SahinS14/ShuddhiSetu/DESIGN_IDEAS.md

This design solves two big problems: **thread fouling** (bentonite dust destroys threads) and **mechanical complexity** (clamps/bolts require extra parts).

Here is how to adapt this cookware concept into a rugged industrial sanitation device.

### 1. Why this works for "Severe Service" (Dust + Pressure)

The oval lid is that the **lid itself is physically larger than the hole** along one axis.

* **Blowout Proof:** In a standard "outside" lid, if the bolts fail, the lid becomes a projectile. In this "inside" design, the pressure pushes the lid *against* the metal rim of the chamber. It is mechanically impossible for the lid to blow off while pressurized.
* **Foul-Resistant:** Because there are no threads, there are no small crevices for your bentonite/magnetite dust to pack into. If dust gets on the rim, the massive force of the internal pressure (the "self-energizing" effect) will simply crush the gasket over the dust, maintaining the seal.

### 2. The Geometry: How to Manufacture It

You do not need complex castings. You can manufacture this using standard stainless steel plate.

* **The Shape:** Both the chamber opening and the lid are **Ellipses** (ovals).
* *Example:* If your opening is 6 inches wide (minor axis) and 7 inches long (major axis), your lid would be 6.5 inches wide and 7.5 inches long.

* **The Insertion Motion:** To insert the lid, you turn it 90 degrees so the lid's *short* side fits through the hole's *long* side. Once inside, you rotate it back 90 degrees and pull it up.
* **Material:** 316 Stainless Steel is ideal for urine/corrosion resistance.

### 3. Adapting for Automation (The "Internal Hinge")

The only downside of the Indian cooker design is that it requires a complex human hand motion (insert, twist, rotate, pull). To make this "mechanically simple" for a device that might be automated or operated easily by a user:

**Add a Single Internal Hinge.**
Instead of a loose lid, attach the oval lid to a hinge *inside* the vessel.

* **Operation:** When the user (or actuator) pushes a lever, the lid swings down and "collapses" slightly into the chamber.
* **Closing:** A spring pulls the lid back up against the hole.
* **Benefit:** This keeps the lid aligned perfectly every time. The user doesn't have to fiddle with the geometric puzzle of fitting the oval through the hole; the hinge guides it.

### 4. The Seal Interface (Combining your ideas)

To make this work with the "high compliance" idea:

1. **The Gasket:** Place a thick, soft **Silicone or EPDM gasket** around the *top rim* of the oval lid.
2. **The Seat:** The rim of the chamber opening should be smooth.
3. **The "Pre-Tension":** You mentioned a "partial seal." In the Indian cooker, a handle clips onto a bar to pull the lid up gently. For your device, use a **Simple Cam Lever**.
* *Step 1:* User drops lid in.
* *Step 2:* User pulls a small lever that pulls the lid up with ~5 lbs of force. This squishes the soft gasket just enough to make it airtight.
* *Step 3:* Induction starts -> Pressure builds -> Lid seals with 1000+ lbs of force.

### 5. Specific Caution: Induction Heating

* **Risk:** If your induction coils are wrapped around the *outside* of the stainless steel chamber near the lid, the **lid itself might heat up** via induction, potentially melting your gasket.
* **Solution:** Ensure your induction coils are focused lower down on the magnetite payload, or use a non-conductive ceramic/composite spacer ring between the heated zone and the steel sealing rim.

### Summary

It is the most robust, fail-safe, and foul-resistant pressure vessel design available.

* **Action:** Design an elliptical opening.
* **Seal:** Top-mounted gasket on the lid.
* **Mechanism:** "Drop, Twist, Pull" (manual) or "Internal Hinge" (semi-auto).

---

## Update: Critical Design Decision - The "Potted" Internal Coil

This is a critical design decision.

For your specific goal—heating the **Magnetite** directly (to use its high surface area for rapid evaporation)—the answer is **INSIDE**.

### The Physics: Why "Outside" Fails

If you wrap induction coils around the *outside* of a stainless steel or aluminum pressure vessel:

1. **Faraday Cage Effect:** The metal wall will intercept the magnetic field.
2. **Wall Heating:** The induction energy will heat the **chamber wall**, not the magnetite. The wall will get extremely hot, and the magnetite will only heat up slowly via conduction from the wall. This defeats the purpose of using magnetite as a volumetric heating element.
3. **Aluminum Efficiency:** If you use Aluminum, it is so conductive that it will reflect/absorb almost 100% of the field instantly.

### The Solution: The "Potted" Internal Coil

You must place the coils **inside** the pressure boundary, but you cannot expose bare copper coils to urine and abrasive clay.

* **Design:** Cast the copper induction coil inside a cylinder of **high-temperature refractory cement** or **castable silicone**.
* **Function:** This creates a "removable liner" (like a bucket). The waste goes inside this liner.
* **Safety:** The Stainless Steel pot handles the **pressure**. The Ceramic Liner handles the **electricity and heat**.

### 2. The Magnetite Catalyst (CO & NOx Killer)

Magnetite acts as a dual-function catalyst here:

1. **Oxidation:** Converts Carbon Monoxide () to Carbon Dioxide ().
2. **De-NOx (SCR):** Your waste contains **Urine** (Ammonia/Urea). In the presence of Magnetite and heat, the Ammonia reacts with Nitrogen Oxides () to form harmless Nitrogen () and Water. This is the exact principle used in diesel trucks (SCR), but you are generating your own "Diesel Exhaust Fluid" (ammonia) from the urine!

**Heating Method:**

* **Do not use a second induction coil.** It adds massive complexity (interference between coils, dual power supplies).
* **Use a Cartridge Heater.** A simple, robust stainless steel heating rod inserted down the center of your catalyst tube. It is cheap, easy to control (PID), and robust.

### 3. Updated Design: The "All-in-One" Lid Assembly

* **The Pot:** Remains a simple Oval shell.
* **The Liner:** Remains the Ceramic/Induction bucket.
* **The Lid:** Now features a **"Reaction Tower"**.
* **Bottom:** Steam Valve.
* **Middle:** Magnetite Catalyst Chamber (heated).
* **Top:** Clean Exhaust Outlet.

### 4. Technical Explanation of the "Tower"

#### A. The Steam Cleaning Valve (Blue Block)

* **Placement:** Directly above the lid center hole.
* **Logic:** The valve is the "Gatekeeper."
* **Phase 1 (Cooking):** Valve Closed. Pressure builds to 15 PSI. Temperature hits 121°C. Sterilization occurs.
* **Phase 2 (Venting):** Valve Opens. The 15 PSI pressure blasts steam through the valve. This high velocity prevents "gunk" from settling on the seat.
* **Component:** Use a **PTFE-seated Stainless Steel Solenoid Valve** (rated for >180°C steam).

#### B. The Magnetite Catalyst (Dark Grey Cylinder)

* **Placement:** Immediately *after* the valve.
* **Why here?** The gas leaving the valve is hot, but maybe not hot enough for catalysis (needs ~300°C+).
* **The Heater (Gold Rod):** A **Cartridge Heater** runs down the center of the pipe.
* It heats the Magnetite pellets surrounding it to ~350°C.
* As the VOCs, CO, and Steam pass through the hot pellets, they are "cracked" and oxidized.
* **Efficiency:** Because the gas is forced through the hot pellet bed, contact time is high. The "Cartridge Heater in the Center" is the most energy-efficient way to heat a gas stream (heating from the inside out).

#### C. Electrical Feedthrough (Goldenrod)

* Since the coil is inside the pot, we need to get power to it.
* The Lid has a **High-Amperage Ceramic Feedthrough**.
* **Connection:** When you lower the lid into the pot, you plug the coil into the bottom of the lid (using a high-temp connector like a ceramic terminal block), then twist and lock the lid.

### 5. High-Temperature Bottom Cartridge (H2S Scrubbing)

To prevent downstream corrosion of the steam valve and heat exchanger, a high-temperature scrubbing cartridge is integrated at the bottom of the vessel.

* **Placement:** Located at the base of the reaction vessel, serving as the exit "choke point" for the downdraft gas flow.
* **Composition:** A modular Silicon Carbide (SiC) and Magnetite matrix.
* **Function:** Operates at peak induction temperatures (800°C+) to chemically strip Hydrogen Sulfide (H₂S) from the syngas stream before it exits the vessel. This protects the stainless steel solenoid valve and thermal recovery hardware from sulfuric acid corrosion.
* **Maintenance:** Designed as a drop-in replaceable cartridge.

---

## Future Development: Syngas Processing and Advanced Catalysis

For detailed engineering considerations on managing exhaust gases, practical lean combustion syngas conversion, and sulfur mitigation strategies within the biochar mix, please refer to the advanced development memo: [Syngas Processing Memo](Project Files/Memos/Syngas_Processing_Memo.md).

---

## System Monitoring & Valorization

The project utilizes a pressure cooker, modified with a 1" solenoid and an integrated induction heating loop. The induction loop itself is quite large, needing to encompass human fecal matter. The system uses a pressure sensor to monitor the state of the system; because we use pressure, we can monitor the state of valorization.
