SahinS14/ShuddhiSetu/.Jules/palette.md

## 2024-05-18 - Added keyboard accessibility to presentation deck
**Learning:** The presentation deck had a `#present-btn` that only indicated its action via a FontAwesome icon (`<i class="fa-solid fa-desktop"></i>`). While there was text "Present", screen readers could get confused by the icon without `aria-hidden="true"`. Furthermore, when switching to presentation mode, there was no shortcut hint. Adding `aria-label` and `title` to the button and dynamically updating them via JavaScript improves both screen reader experience and regular mouse/keyboard accessibility by exposing the `(Esc)` hint. Also added `:focus-visible` to interactive elements to help keyboard navigators, matching the color theme (`#B89E6B`).
**Action:** Always add `aria-hidden="true"` to pure decorative FontAwesome icons, add `aria-label`/`title` tooltips for action buttons, and remember to update `aria-label` state via JavaScript for toggle buttons. Ensure `:focus-visible` outlines match the design system's accent color.
## 2026-06-16 - Presentation Mode Keyboard UX
**Learning:** In custom presentation modes triggered by a button click, leaving focus on the button causes spacebar navigation to double-trigger the click event, exiting the mode. Also, default keyboard events (like Space or Arrows) can cause unwanted scrolling if not prevented.
**Action:** Use `.blur()` on toggle buttons after activation if the mode radically alters the UI, and add `e.preventDefault()` in keyboard navigation listeners for custom UI states.

## 2024-03-24 - Custom Presentation UX Feedback
**Learning:** When building custom HTML presentation decks (like `ShuddhiSetu_Slide_Deck.html`), native browser progress and navigation cues are lost. Adding a fixed visual progress bar with ARIA progressbar roles, and updating fullscreen toggle buttons' `title` and `aria-label` to explicitly list keyboard shortcuts (e.g. Space/Arrows), significantly improves the discoverability of navigation and overall screen reader accessibility.
**Action:** Always include an ARIA-enabled progress indicator for multi-step or paginated custom UI views, and explicitly state hidden keyboard navigation shortcuts in the ARIA labels of the UI controls that initiate those views.
