SahinS14/ShuddhiSetu/Project Files/Memos/Syngas_Processing_Memo.md

# Syngas Processing Memo: Advanced Considerations

**Note:** This is an advanced idea regarding catalytic and gas management incorporated directly into the biochar mixture and ceramic liner design considerations.

## Syngas to CO₂ Conversion Pathways

Syngas exiting your Downdraft Silicon Carbide (SiC) choke point consists primarily of Carbon Monoxide (CO), Hydrogen (H₂), and trace Methane (CH₄). To convert this into Carbon Dioxide (CO₂), we will focus on the most practical engineering pathway for a decentralized appliance.

### Catalytic Oxidation (Lean Combustion)

To maximize reliability and minimize system complexity, you can oxidize the syngas.

*   **The Chemistry:** Introduce a controlled amount of ambient air or pure oxygen to the syngas stream as it passes over an oxidation catalyst (or just a secondary combustion chamber).
*   **The Equations:**
    *   `2CO + O₂ → 2CO₂`
    *   `2H₂ + O₂ → 2H₂O`
    *   `CH₄ + 2O₂ → CO₂ + 2H₂O`
*   **The Result:** The syngas burns clean, leaving you with only CO₂ and water vapor.
*   **System Synergy:** This is an exothermic (heat-generating) reaction. You can capture this waste heat to pre-heat your incoming waste or power a thermoelectric generator. Once the water vapor is condensed out, you have a pure CO₂ stream.

## Economic Analysis: Syngas Processing

When evaluating the cost-effectiveness of your Biochar Induction Toilet's exhaust processing, we must prioritize the rugged simplicity of thermal oxidation.

### Lean Combustion (The "Burn It" Route)

*   **Philosophy:** Maximize reliability, minimize parts, and reduce the system's overall electrical draw.
*   **CapEx (Capital Cost):** VERY LOW.
*   **Hardware:** Requires only an ambient air-injection valve (a venturi or small blower) right after the 1000°C SiC catalytic plug, plus a heat exchanger or Thermoelectric Generator (TEG).
*   **Complexity:** No exotic materials required beyond the existing high-temp plumbing.
*   **OpEx (Operational Cost):** NEGATIVE (Saves Money).
*   **Energy:** Burning syngas (CO, H₂, CH₄) is highly exothermic. By routing this waste heat via a heat exchanger back to the primary pyrolysis vessel, you drastically reduce the electrical load required by your primary induction coil.
*   **Maintenance:** Almost zero. There are no membranes to foul or salts to replace.
*   **ROI / Value:** The return on investment comes purely from energy efficiency (lower electricity bills) and extreme reliability, which lowers the lifetime maintenance cost of the toilet.

**The Engineering Verdict**

For a Household / Decentralized Appliance, Lean Combustion is the clear winner. Homeowners want a toilet that never breaks, has no odor, and doesn't spike their power bill. Capturing the heat to lower the induction coil's power draw makes this highly cost-effective and practical.

## Sulfur Mitigation: Protecting the Base Unit

In the Lean Combustion base model, our goal is to burn the syngas to recover heat. However, the H₂S present in fecal syngas poses a severe corrosion threat to heat exchangers (H₂SO₄).
To maintain the "rugged and cheap" philosophy, we must avoid complex liquid scrubbers and instead rely on solid-state chemical capture before the combustion phase.

### Strategy 1: In-Situ Fixation (The "Zero-Hardware" Route)

You are already investigating blending mineral additives (like magnetite and kaolinite) into the waste to passivate heavy metals. You can use this exact same mechanism to trap sulfur inside the biochar before it ever becomes a gas.

*   **The Chemistry (Iron):** Magnetite (Fe₃O₄) under reducing conditions (pyrolysis) will react directly with sulfur compounds to form stable, solid Iron Sulfide (FeS, pyrite/pyrrhotite phases).
    *   `Fe₃O₄ + 3H₂S + H₂ → 3FeS + 4H₂O`
*   **The Chemistry (Calcium):** By adding agricultural lime (Calcium Carbonate, CaCO₃, or Calcium Hydroxide, Ca(OH)₂) to your mineral blend, it calcines into Calcium Oxide (CaO). This acts as a powerful in-situ sulfur sponge.
    *   `CaO + H₂S → CaS + H₂O`

*   **The Engineering Value:**
    *   **CapEx:** $0. No additional plumbing or chambers required.
    *   **OpEx:** Pennies per batch. Lime and iron dust are incredibly cheap.
    *   **Result:** The sulfur is permanently locked into the solid biochar matrix as inert metal sulfides. The syngas exiting the bottom of your pot is significantly desulfurized natively.

### Strategy 2: The "Iron Sponge" Dry Scrubber (The Hardware Route)

If in-situ fixation isn't enough to protect your heat exchanger, you need a pre-combustion dry scrubber. The industry standard for cheap, low-tech biogas desulfurization is the "Iron Sponge."

*   **The Concept:** A simple, unheated steel canister placed inline between your SiC catalytic exhaust port and your combustion chamber.
*   **The Media:** It is filled with wood chips or steel wool coated in hydrated iron oxide (Fe₂O₃·H₂O).
*   **The Chemistry (Capture):** As the warm syngas passes through, the H₂S binds to the iron, stripping it from the gas stream.
    *   `Fe₂O₃ + 3H₂S → Fe₂S₃ + 3H₂O`
*   **The Chemistry (Regeneration):** The true beauty of the Iron Sponge is that it is passive to regenerate. When the toilet is offline, exposing the canister to ambient air (oxygen) converts the iron sulfide back into iron oxide, dropping out pure, elemental sulfur as a solid dust.
    *   `2Fe₂S₃ + 3O₂ → 2Fe₂O₃ + 6S` (Solid Elemental Sulfur)

*   **The Engineering Value:**
    *   **CapEx:** Very low. Just a sealed steel tube with basic mesh filters at both ends.
    *   **OpEx:** Minimal. The media lasts for months or years depending on regeneration cycles, and replacement media (iron-coated wood chips) is DIY-friendly and ultra-cheap.

### Strategy 3: The High-Temperature Ceramic/Magnetite Cartridge (The Choke Point Scrubber)

This strategy leverages the peak temperatures at the bottom of the induction vessel to maximize chemical reaction rates.

*   **The Concept:** A replaceable Silicon Carbide (SiC) and Magnetite cartridge located at the bottom of the pot, serving as the final "choke point" for the downdraft gas path.
*   **The Chemistry:** At temperatures exceeding 800°C, the reaction between H₂S and the concentrated magnetite in the cartridge becomes extremely efficient. The SiC matrix ensures the cartridge remains structurally sound and highly thermally conductive, staying at peak temperature throughout the cycle.
*   **The Engineering Value:**
    *   **Maximized Efficiency:** Concentrating the scrubbing media in the hottest zone of the reactor ensures that even refractory sulfur compounds are cracked and captured.
    *   **Hardware Protection:** By removing H₂S inside the primary vessel before it reaches the solenoid valve or the external heat exchanger, you virtually eliminate high-temperature sulfuric corrosion in your expensive plumbing.
    *   **Modularity:** The cartridge can be easily replaced during routine maintenance, similar to a ceramic oil filter.

### The Recommended Architecture

Combine all three for a "Zero-Corrosion" system.

1.  **In-Situ Fixation:** Dose waste with Lime/Magnetite to capture the bulk of the sulfur in the biochar.
2.  **High-Temp Cartridge:** Force the exiting syngas through the bottom SiC/Magnetite cartridge at 800°C+ to scrub the majority of the remaining H₂S.
3.  **Iron Sponge:** Use a small, passive external canister for final polishing and as a visual indicator of system health.
4.  **Clean Combustion:** Burn the purified syngas for heat recovery with zero risk to the heat exchanger.

This keeps the base unit virtually maintenance-free while drastically extending the lifespan of your thermal recovery hardware.

## Engineering Brief: Modular Ceramic Assembly & Baffle Tolerances

When designing the ceramic heat exchanger for the Biochar Induction Toilet, moving away from a monolithic (single-piece) cast to a modular assembly (separate inner wall, outer jacket, and baffle inserts) drastically reduces manufacturing complexity.

To answer the core question: **No, the internal baffles do not need to be air-tight against the walls. In fact, designing them with a slight "leaky" slip-fit is highly recommended.**

### 1. The "Leaky" Advantage: Thermal Decoupling

If you were to rigidly bond (or co-cast) the complex baffles directly to the inner and outer walls, you would create a thermal time bomb.

*   **Differential Expansion:** The inner wall facing the induction susceptor will be hundreds of degrees hotter than the outer insulating jacket.
*   **Thermal Shear:** If the baffles connect these two walls with a rigid, air-tight seal, the inner wall will expand more than the outer wall, placing massive shear stress on the baffles until they snap.
*   **The Slip-Fit Solution:** By allowing the baffle insert to sit loosely (with a tolerance gap of a few millimeters) between the inner and outer jackets, the components can expand and contract independently. A "leaky" mechanical fit prevents catastrophic thermal cracking.

### 2. Managing Fluid Dynamics (The Path of Least Resistance)

The trade-off of a leaky seal is fluid dynamics. Gases will always take the path of least resistance.

*   **The Risk:** If the gap between your active ceramic sponge/baffles and the smooth wall is too large, the venturi will pull the hot gases straight up the smooth gap, bypassing the heat-transferring matrix entirely.
*   **The Mitigation (Labyrinth Edges):** You do not need a chemical seal, but you do need a tortuous path. You can design the outer edge of your baffle inserts with interlocking steps, or simply wrap the edges of the ceramic sponge in a compressible high-temp ceramic fiber blanket (like Kaowool) before sliding it into the jacket. This acts as a soft, high-temp "piston ring" that forces the gas through the sponge without creating a rigid bond.

### 3. The Modular Architecture (Material Optimization)

Your proposal to use different materials for the separate components is exactly how industrial high-temperature reactors are built. This allows you to optimize each layer:

*   **The Inner Sleeve (Heat Transfer):** A simple, straight tube made of dense, high-thermal-conductivity ceramic, such as Silicon Carbide (SiC) or high-purity Alumina. It transfers heat efficiently but is easy to manufacture because it has no complex geometry.
*   **The Baffle/Sponge Insert (The Core):** A stackable series of complex Cordierite baffles or a cylinder of reticulated ceramic foam. This drops over the inner sleeve. Because it is separate, you can easily coat this specific part in your active sulfur-scrubbing washcoat.
*   **The Outer Jacket (Insulation):** A thick, simple tube made of highly insulating material, like porous mullite, zirconia, or a refractory castable. It contains the gas flow and protects the outer pressure vessel.

### 4. Manufacturing and Maintenance Value

*   **Reduced CapEx:** Creating a mold for a double-walled vessel with internal spiraling baffles is incredibly expensive and prone to casting defects. Casting three simple nested cylinders is cheap and highly repeatable.
*   **Serviceability:** If the active sponge eventually becomes fouled with ash or degraded by acid gases, the user can simply open the pressure vessel, pull out the modular sponge insert, and drop in a replacement cartridge, rather than replacing the entire ceramic assembly.
