SahinS14/ShuddhiSetu/images/image.webp

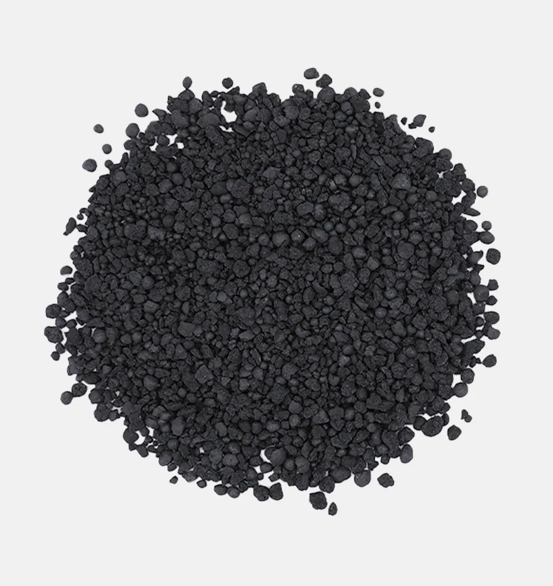
images/image.webp
