SahinS14/ShuddhiSetu/images/s-blob-v1-IMAGE-u5mOaW5JDZ4.webp

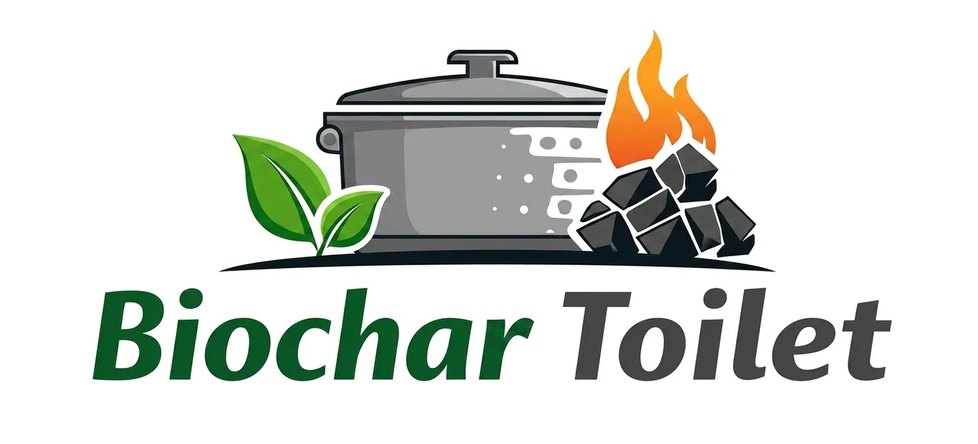
images/s-blob-v1-IMAGE-u5mOaW5JDZ4.webp
