SahinS14/ShuddhiSetu/Project Files/BOM/1st_Action_Pyrolysis_BOM.ods

 | Pyro-T Project BOM: 1st Actionable Item: Achieve Pyrolysis
Index | Nomenclature | Description | Order Link | Units | Cost | Total ( Pre-Tax)
 | Pressure Vessel: 12L (12.2qt) | Hawkins 12 Liter Classic Pressure Cooker, Best Inner Lid Cooker, Silver (CL412) | Amazon: Hawkins 12L Order Page (https://www.amazon.com/dp/B00VNMLIZU/?th=1) | 1ea | $78.98 | $860.16
 | Dual-Channel Thermocouple & Meter | Dual-Channel K/J Thermocouple Thermometer with 4 K-Type Thermocouples -328°F ~ 2501°F Measurement Range HVAC Temperature Meter Gauge with Data Hold, MAX/MIN/AVG, Hi/Lo Backlit Alarm, ADJ Compensation | Amazon: Dual-Thermocouple-Meter (https://www.amazon.com/Landtek-Thermocouple-Thermometer-328-2501°F-Compensation/dp/B0C4YL76WY?s=industrial) | 1ea | $28.99
 | Ceramic Sheath: Thermocouple | High Temperature Ceramic Protection Tube Sheath for K-Type Thermocouple for Kiln Furnace for Pottery, Glass Fusing, Metal Working 8 inch Long | Amazon: Ceramic Sheath (https://www.amazon.com/Temperature-Ceramic-Protection-Thermocouple-Furnace/dp/B0CQTSTKYP) | 1ea | $25.99
 | High Heat Silicone Rubber | Mold Max 60 - High Heat Resistant Silicone Rubber Compound - Gallon Unit | Mold Max 60 - High Heat Resistant Silicone Rubber Compound - Gallon Uni (https://www.amazon.com/Mold-Max-60-Resistant-Silicone/dp/B09MJPZH22?th=1) | 1ea | $35.27
 | Heat Exchanger | Heat Exchanger | Heat Exchanger (https://www.amazon.com/Milageto-Condenser-Refrigerator-Exchanger-Industrial/dp/B0FHH1HCQW?th=1) | 1ea | $43.09
 | Hot Water Recirculating Pump | Hot Water Recirculating Pump, 93W, 110V Water Circulator Pump, Circulation Pump, 3/4″ G Thread to 1/2″ NPT Brass Adapter, Stainless Steel Head | Hot Water Recirculating Pump (https://www.amazon.com/VEVOR-Recirculating-Pump-93W-Circulating/dp/B09N92QGJD/?th=1) | 1ea | $43.99
 | 2" Universal Catalytic Converter | 2" Universal Catalytic Converter | 2" Universal Catalytic Converter (https://www.amazon.com/ASOPARTS-Universal-Catalytic-Converter-Outlet/dp/B0CMLWHZ7C/) | 1ea
 | High temp air filter |  |  | 1ea
 | Coil stand-off |  |  | 1ea
 | Crucible/fiberglass sack/bag | Holds, bentonite |  | 1ea
 | Electrical Insulation ¼” bulkhead | Induction coil ¼” passthrough bulkhead |  | 1ea
 | Bentonite Clay Granules | Unscented Clumping Clay Cat Litter | Unscented Clumping Clay Cat Litter (https://www.amazon.com/Dr-Elseys-Precious-Ultra-Litter/dp/B0009X0QSY/?th=1) | 1ea
 | Black Iron Oxide - Fe3O4 | Black Iron Oxide - Fe3O4 - Natural - 5 Pounds | Black Iron Oxide - Fe3O4 (https://www.amazon.com/Black-Iron-Oxide-Natural-Pounds/dp/B004KICAVU) | 1ea | $19.99
 | Camera Pole Mount Bracket | Sumnacon Camera Pole Mount Bracket, 2 Pcs Stainless Steel Pole Mount | https://www.amazon.com/Sumnacon-Stainless-Brackets-Universal-Security/dp/B0DPJ1XPV8/ | 1ea
 | Fuel Cell Bulkhead Adapter Fittings SUM-220682B | Fitting, Fuel Cell, Male Bulkhead, -6 AN, Aluminum, Black Anodized, Each | https://www.summitracing.com/parts/sum-220682b | 1ea
 | Chemical-Resistant Slippery PTFE Tube | 3/8" OD x 1/4" ID | https://www.mcmaster.com/8547K11/ | 1ea
 | McMaster-Carr Part 2227K62 |  | https://www.mcmaster.com/2227K62/ | 1ea
 | PTFE Plastic Washer | for Number 12 Screw Size, 0.250" ID, 0.562" OD | https://www.mcmaster.com/95630A898/ | 1ea
 | 304 SS Threaded Pipe Fitting | 304 SS Threaded Pipe Fitting, Tee Connector, 1 NPT Female | https://www.mcmaster.com/4464K53/ | 1ea
 | MEAN WELL RSP-2400-48 AC to DC Power ... | MEAN WELL RSP-2400-48 AC to DC Power Supply | Amazon: MEAN WELL RSP-2400-48 | 1ea
 | Beduan 1" Female Bulkhead Water Tank ... | Beduan 1" Female Bulkhead Water Tank Connector | Amazon: Beduan 1" Female Bulkhead | 1ea
 | 1" Male Hex Nipple Pipe Fittings | 1" Male Hex Nipple Pipe Fittings | Amazon: 1" Male Hex Nipple | 1ea
 | GOORY Copper Tubing 1/4" OD x 0.187" ... | GOORY Copper Tubing 1/4" OD x 0.187" ID x 50Ft | Amazon: GOORY Copper Tubing | 1ea
 | 1800W 12V-48V ZVS Low Voltage DC Indu... | 1800W 12V-48V ZVS Low Voltage DC Induction Heater | Amazon: 1800W Induction Heater | 1ea
 | Kidde Carbon Monoxide Detector | Kidde Carbon Monoxide Detector, Battery Powered | Amazon: Kidde Carbon Monoxide Detector | 1ea
 | U.S. Solid 1" Solenoid Valve - Stainl... | U.S. Solid 1" Solenoid Valve - Stainless Steel | Amazon: U.S. Solid 1" Solenoid Valve | 1ea
 | uxcell 2mm Bearing Balls | uxcell 2mm Bearing Balls, 100 Pcs 440C Stainless Steel G10 | Amazon: uxcell 2mm Bearing Balls, 100 Pcs | 1ea
 | 100Pcs 3mm Diameter Steel Bike Bicycl... | 100Pcs 3mm Diameter Steel Bike Bicycle Bearing Ball Spares T3T5 | Amazon: 100Pcs 3mm Diameter Steel Bike Bearing Ball | 1ea
 | uxcell 10000pcs 2mm Carbon Steel Bear... | uxcell 10000pcs 2mm Carbon Steel Bearing Balls G1000 Precision | Amazon: uxcell 10000pcs 2mm Carbon Steel Bearing Balls | 1ea
 | uxcell 10000pcs 1mm Carbon Steel Bear... | uxcell 10000pcs 1mm Carbon Steel Bearing Balls G1000 Precision | Amazon: uxcell 10000pcs 1mm Carbon Steel Bearing Balls | 1ea
