SahinS14/ShuddhiSetu/Project Files/PCB Design/Bio_Char_BOM_Mouser_FINAL.xlsx

Bio-Char Control Board - Mouser BOM
Item | Qty | References | Value | Description | Package/Footprint | Specifications | Manufacturer | MPN | Mouser PN | Unit Price | Ext Price | Notes
▼ CAPACITORS
1 | 3 | C1, C3, C5 | 100nF | Ceramic bypass capacitors | Disc 5.0mm | 50V, X7R, ±10% | Kemet | C322C104K5R5TA7305 | 80-C322C104K5R5TA | $0.87 | $2.61 | Input/Output & MAX31855 bypass
2 | 2 | C6, C7 | 47µF 25V | Aluminum electrolytic capacitors | Radial D6.3mm P2.5mm | 25V, 105°C (C7=16V covered) | Cornell Dubilier | 476CKH025M | 598-476CKH025M | $0.21 | $0.42 | U3 input/output filtering
▼ RESISTORS (All 1/4W, Through-Hole)
3 | 6 | R1,R3,R5,R7,R9,R11 | 1kΩ | Carbon film resistors 1/4W ±5% | Axial 7.62mm | 1/4W, ±5%, 1kΩ | YAGEO | CFR-25JR-52-1K | 603-CFR-25JR-521K | $0.18 | $1.08 | Current limit, base resistors
4 | 4 | R2,R8,R10,R12 | 100kΩ | Carbon film resistors 1/4W ±5% | Axial 7.62mm | 1/4W, ±5%, 100kΩ | YAGEO | CFR-25JB-52-100K | 603-CFR-25JB-52-100K | $0.18 | $0.72 | MOSFET pull-down resistors
5 | 2 | R4, R14 | 10kΩ | Carbon film resistors 1/4W ±5% | Axial 7.62mm | 1/4W, ±5%, 10kΩ | YAGEO | CFR-25JB-52-10K | 603-CFR-25JB-52-10K | $0.10 | $0.20 | Pull-up resistors
6 | 2 | R6, R15 | 22kΩ | Carbon film resistors 1/4W ±5% | Axial 7.62mm | 1/4W, ±5%, 22kΩ | YAGEO | CFR-25JB-52-22K | 603-CFR-25JB-52-22K | $0.10 | $0.20 | Voltage divider resistors
▼ DIODES
7 | 2 | D1, D4 | 1N4001RLG | Rectifier diodes 50V 1A | DO-41 P10.16mm | 50V, 1A, DO-41 | onsemi | 1N4001RLG | 863-1N4001RLG | $0.13 | $0.26 | SSR protection diodes
8 | 2 | D2, D5 | 1N4148 | Switching diodes 100V 150mA | DO-35 P7.62mm | 100V, 150mA, DO-35 | onsemi | 1N4148 | 512-1N4148 | $0.10 | $0.20 | Flyback protection diodes
9 | 1 | D3 | 1N5819RLG | Schottky diode 40V 1A | DO-41 P10.16mm | 40V, 1A Schottky | onsemi | 1N5819RLG | 863-1N5819RLG | $0.39 | $0.39 | Reverse polarity protection
▼ MICROCONTROLLER & POWER MANAGEMENT
10 | 1 | U1 | ESP32-H2-DEVKITM-1-N4 | WiFi/BLE development module | ESP32-H2 Module | 802.11n, BLE 5.2, 4MB Flash | Espressif | ESP32-H2-DevKitM-1-N4 | 356-ESP32H2DKITM1-N4 | $9.38 | $9.38 | Main microcontroller
11 | 1 | U3 | R-78E5.0-1.0 | 12V→5V 1A switching regulator | SIP-3 | 8-28V in, 5V 1A out, 95% eff | RECOM | R-78E5.0-1.0 | 919-R-78E5.0-1.0 | $3.97 | $3.97 | Buck converter (no heatsink needed)
12 | 1 | F1 | Polyfuse 2A | Resettable fuse PTC 2A | Radial | 2A hold, 4A trip | Bel | 0ZRN0200FF1E | 530-0ZRN0200FF1E | $0.42 | $0.42 | Overcurrent protection
▼ POWER & SIGNAL TRANSISTORS
13 | 2 | Q1, Q3 | IRLB3813PBF | N-channel MOSFETs | TO-220 | 30V, 100A, 2.3mΩ Rds(on) | Infineon | IRLB3813PBF | 942-IRLB3813PBF | $2.16 | $4.32 | ⚠️ Upgrade from IRLB8721 - Better!
14 | 2 | Q2, Q5 | 2N3904BU | NPN transistors | TO-92 | 40V, 200mA, hFE>100 | onsemi | 2N3904BU | 512-2N3904BU | $0.28 | $0.56 | MOSFET gate drivers
▼ CONNECTORS & TERMINALS
15 | 5 | 12V_I/P, Sol1, Sol2, SSR1, SSR2 | Terminal 2-pos | Phoenix terminal blocks 2-position | Phoenix 5.08mm | 2-pos, 5.08mm, 90°, 12A | Phoenix Contact | 1715721 | 651-1715721 | $1.30 | $6.50 | Power input & outputs
16 | 1 | PressureSensor1 | Terminal 3-pos | Phoenix terminal block 3-position | Phoenix 5.08mm | 3-pos, 5.08mm, 90°, 12A | Phoenix Contact | 1715734 | 651-1715734 | $1.66 | $1.66 | Pressure sensor connection
17 | 2 | J2, J3 | Pin Headers | Pin headers 2.54mm | 2.54mm vertical | 1x8 + 1x6, single row | Amphenol ICC | 10129379-908001BLF | 649-1012937990801BLF | $0.14 | $0.28 | I/O & MAX31855 connectors
▼ BREAKOUT MODULES
18 | 1 | MAX3155 | MAX31855 | Thermocouple amplifier breakout | Adafruit #269 | K-type, -200°C to +700°C, SPI | Adafruit | 269 | 485-269 | $14.95 | $14.95 | Thermocouple interface module
TOTAL COST: |  |  |  |  |  |  |  |  |  | $48.12 | $48.12
