SahinS14/ShuddhiSetu/Project Files/CAD Files/Frame for Assembly_v2.2.FCStd

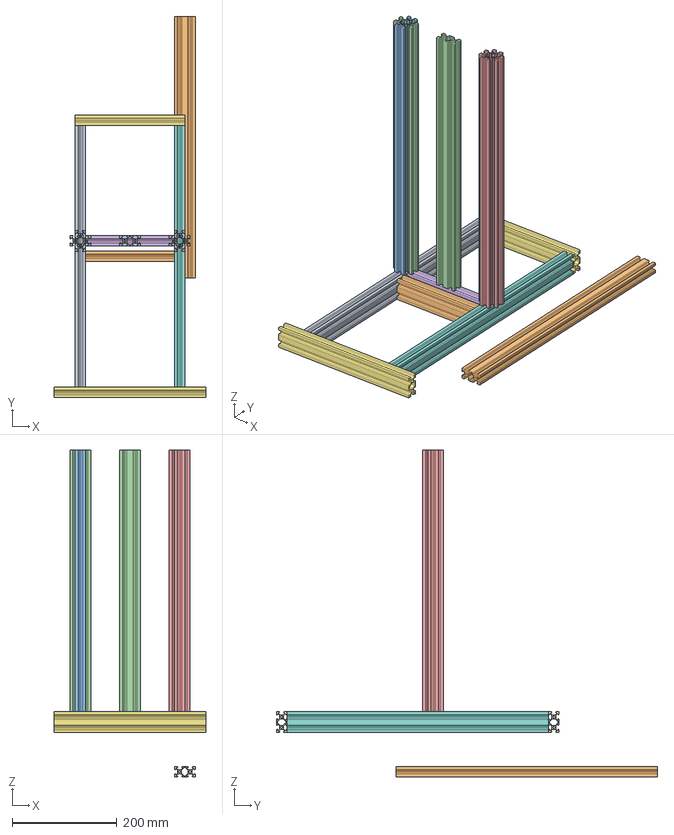
[picture p9: CAD file, 2026-11-09]
Project Files/CAD Files/Frame for Assembly_v2.2.FCStd
289.5 x 728.4 x 624.8 mm
20mmx40mm extruded aluminum
20mmx40mm extruded aluminum007
20mmx40mm extruded aluminum003
20mmx40mm extruded aluminum006
20mmx40mm extruded aluminum005
20mmx40mm extruded aluminum008
20mmx40mm extruded aluminum016
20mmx40mm extruded aluminum010
20mmx40mm extruded aluminum015
20mmx40mm extruded aluminum011
20mmx40mm extruded aluminum014
20mmx40mm extruded aluminum012
20mmx40mm extruded aluminum013
20mmx40mm extruded aluminum018
20mmx40mm extruded aluminum019
20mmx40mm extruded aluminum020
