SahinS14/ShuddhiSetu/Project Files/CAD Files/Custom.concept.tangent.bulkhead.fitting/Custom tangent bulkhead fitting.FCStd

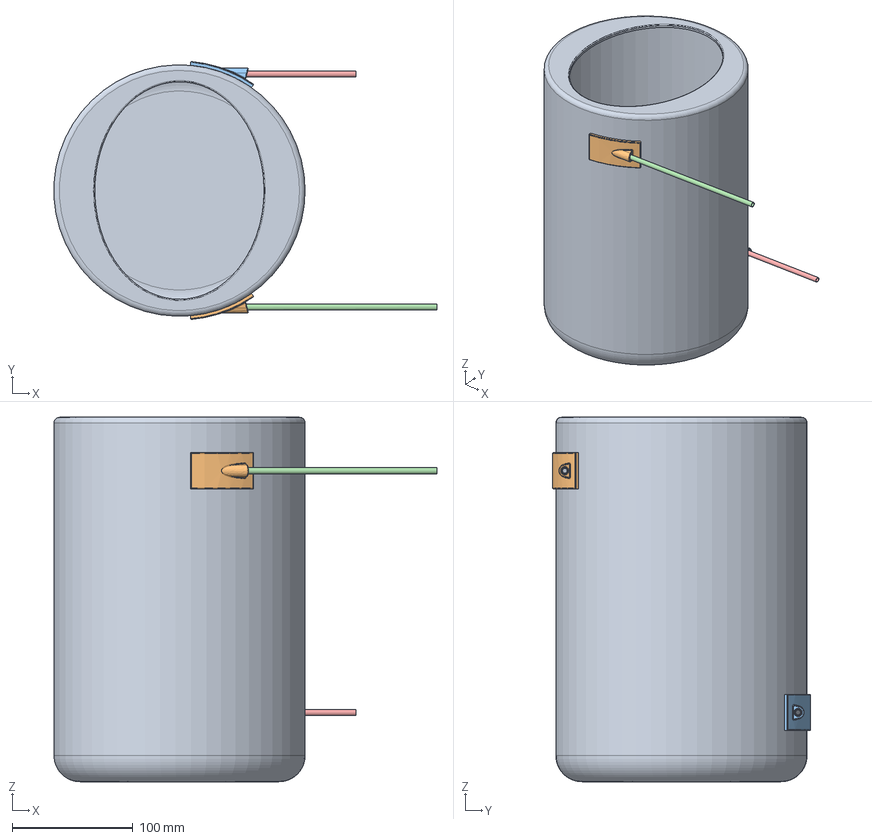
[picture p10: CAD file, 2026-11-09]
Project Files/CAD Files/Custom.concept.tangent.bulkhead.fitting/Custom tangent bulkhead fitting.FCStd
316.9 x 213.4 x 301.6 mm
Base
Custom Tangent fitting example001
Upper-Straight
Lower Straight
