SahinS14/ShuddhiSetu/Project Files/CAD Files/Heat-Exchanger_HTL-10x10.FCStd

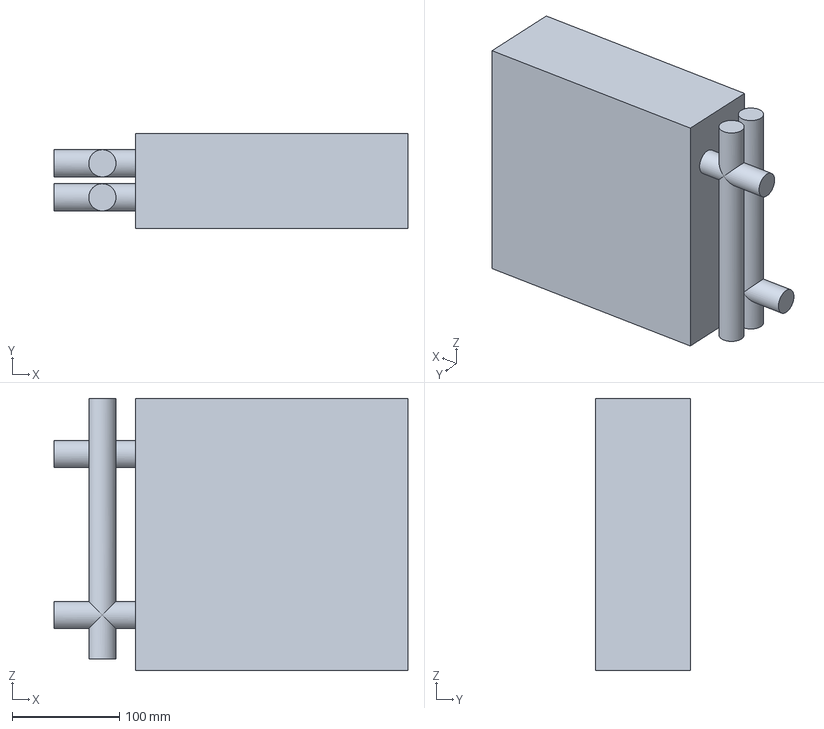
[picture p11: CAD file, 2026-11-09]
Project Files/CAD Files/Heat-Exchanger_HTL-10x10.FCStd
330.2 x 88.9 x 254.0 mm
