SahinS14/ShuddhiSetu/Project Files/CAD Files/Pressure.Vessel_Hawkins.12.Litre_CL12.v1.1/Pressure Vessel_Hawkins 12 Litre_CL12.FCStd

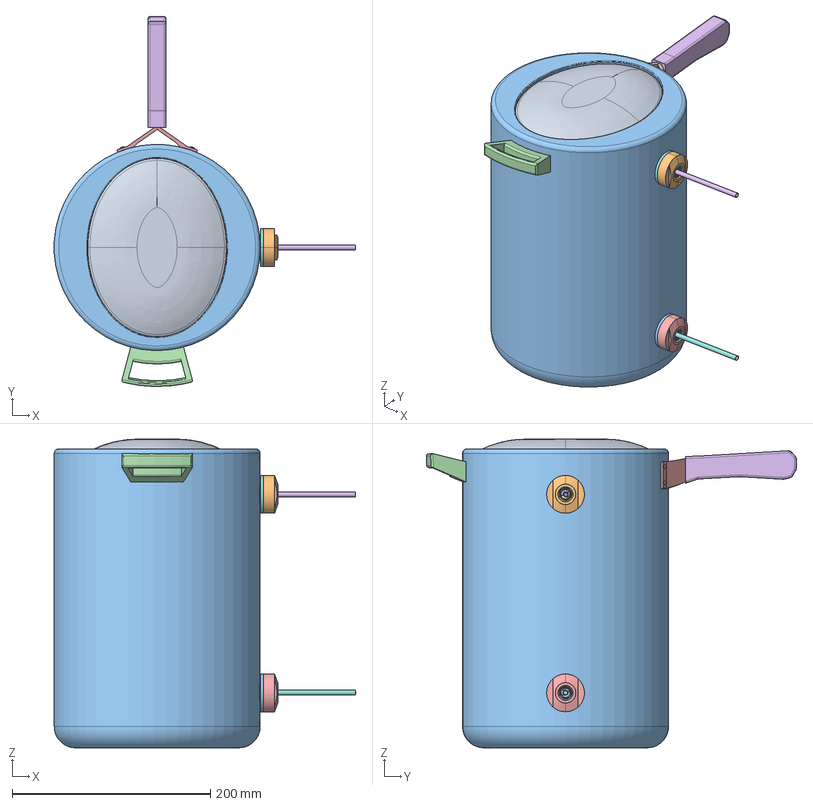
[picture p12: CAD file, 2026-11-09]
Project Files/CAD Files/Pressure.Vessel_Hawkins.12.Litre_CL12.v1.1/Pressure Vessel_Hawkins 12 Litre_CL12.FCStd
304.2 x 373.2 x 311.4 mm
Metal
Gasket
Base
Back-Handle
Long-Handle
Rivets
3773K124_Thick-Wall Plastic Pipe Fitting for Water
3773K124_Thick-Wall Plastic Pipe Fitting for Water001
3773K124_Thick-Wall Plastic Pipe Fitting for Water002
3773K124_Thick-Wall Plastic Pipe Fitting for Water004
3773K124_Thick-Wall Plastic Pipe Fitting for Water005
3773K124_Thick-Wall Plastic Pipe Fitting for Water006
