SahinS14/ShuddhiSetu/Project Files/CAD Files/Heat-Exchanger_HTL-15x20.FCStd

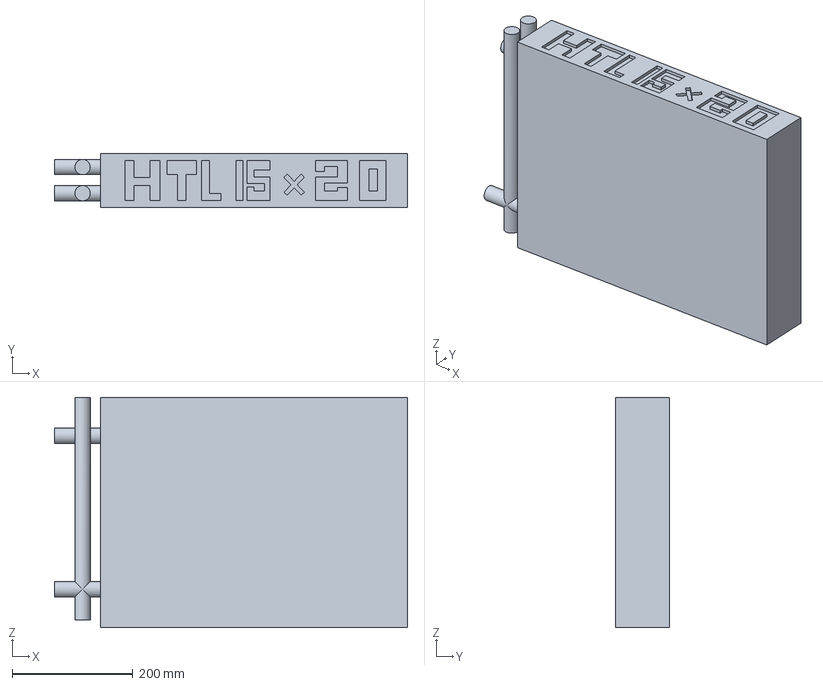
[picture p13: CAD file, 2026-11-09]
Project Files/CAD Files/Heat-Exchanger_HTL-15x20.FCStd
584.2 x 88.9 x 381.0 mm
