SahinS14/ShuddhiSetu/Project Files/CAD Files/RSP-2400-Mean_Well_PSU.FCStd

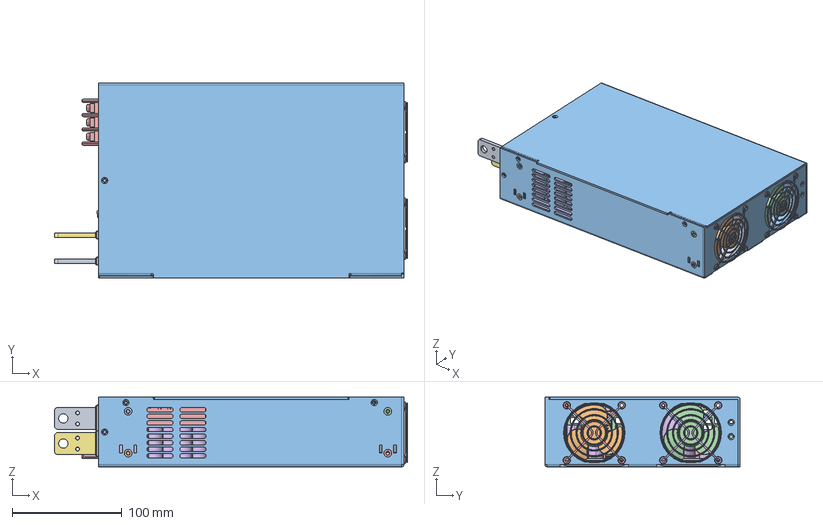
[picture p14: CAD file, 2026-11-09]
Project Files/CAD Files/RSP-2400-Mean_Well_PSU.FCStd
321.2 x 177.8 x 63.5 mm
FAN_4715KL40WB30_2
FAN
FAN_4715KL40WB30_001
FAN001
fan_a.1.1
fan_a.1.001
ff.1.1.1.1.1.1.2
ff.1.1.1.1.1.1.001
ff.1.1.1.1.1.1.002
ff.1.1.1.1.1.1.003
\S\JW\S\#\
M3-7L.1.2
M3-7L.1.001
ff.1.1.1.1.1.1.004
ff.1.1.1.1.1.1.005
ff.1.1.1.1.1.1.006
ff.1.1.1.1.1.1.007
ff.1.1.1.1.1.1.008
ff.1.1.1.1.1.1.009
ff.1.1.1.1.1.1.010
ff.1.1.1.1.1.1.011
M3-7L.1.002
M3-7L.1.003
M3-7L.1.004
M3-7L.1.005
M3-7L.1.006
\X2\02CB\X0\\S\0\S\[y
\S\/\S\%\S\#\.1
JJ.1
VR.1.1
VR.1.001
led.1.1.1
p1
p001
p2
p002
p003
p004
p005
p006
p007
p008
p009
p010
p011
p012
p013
VR.1.002
pcb2
pcb.1
CU1.1.2
GG.2.1.1
CU1.1.001
GG.2.1.001
