SahinS14/ShuddhiSetu/Project Files/CAD Files/Induction_Module_Clearance_model.FCStd

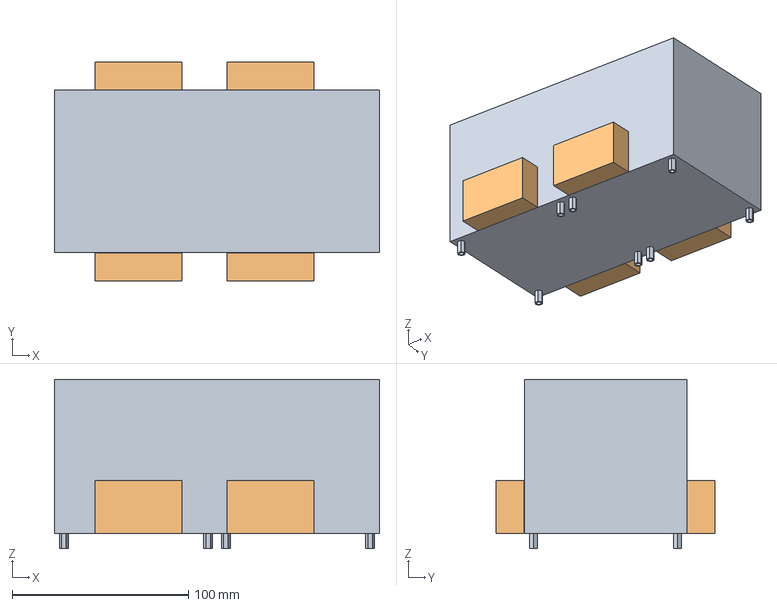
[picture p15: CAD file, 2026-11-09]
Project Files/CAD Files/Induction_Module_Clearance_model.FCStd
184.2 x 123.9 x 95.8 mm
