SahinS14/ShuddhiSetu/Project Files/CAD Files/1inID_304ss_bulkhead fitting.FCStd

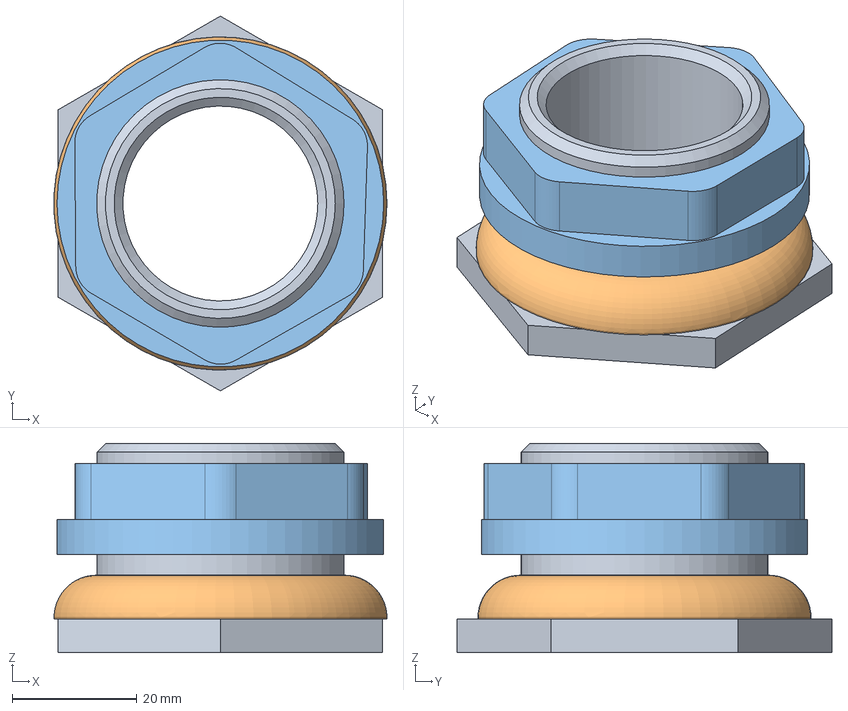
[picture p16: CAD file, 2026-11-09]
Project Files/CAD Files/1inID_304ss_bulkhead fitting.FCStd
53.3 x 60.0 x 33.5 mm
Seal
