SahinS14/ShuddhiSetu/Project Files/CAD Files/4464K53_NO THREADS_304 Stainless Steel Threaded Pipe Fitting.FCStd

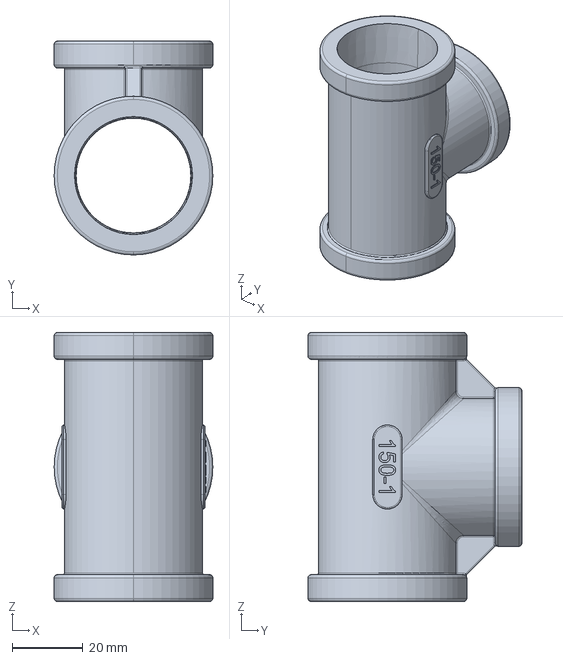
[picture p17: CAD file, 2026-11-09]
Project Files/CAD Files/4464K53_NO THREADS_304 Stainless Steel Threaded Pipe Fitting.FCStd
45.0 x 60.6 x 76.2 mm
