SahinS14/ShuddhiSetu/Project Files/CAD Files/Frame for Assembly_v2.0.FCStd

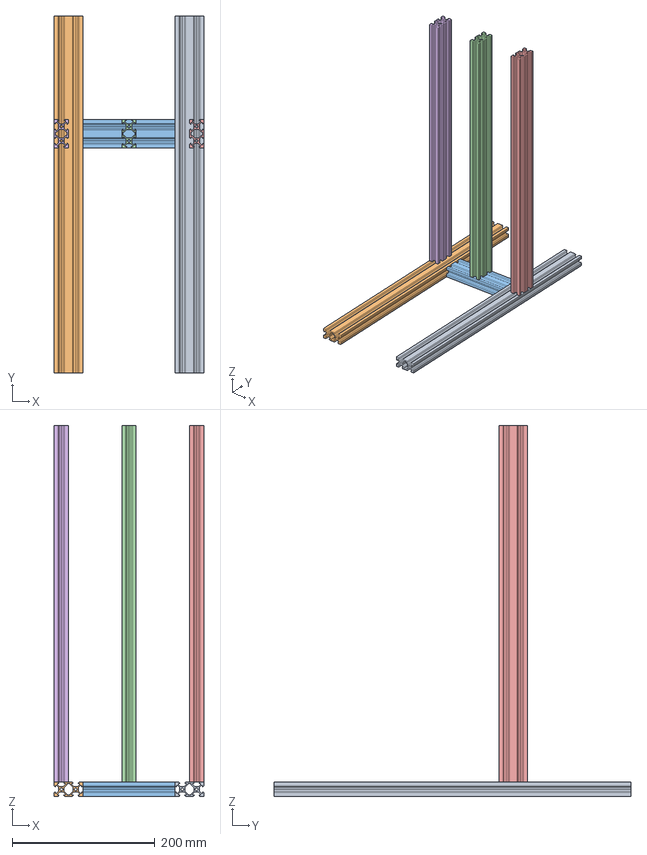
[picture p18: CAD file, 2026-11-09, an earlier design]
Project Files/CAD Files/Frame for Assembly_v2.0.FCStd
209.6 x 500.0 x 520.0 mm
20mmx40mm extruded aluminum
20mmx40mm extruded aluminum007
20mmx40mm extruded aluminum003
20mmx40mm extruded aluminum004
20mmx40mm extruded aluminum005
20mmx40mm extruded aluminum006
