SahinS14/ShuddhiSetu/Project Files/CAD Files/Frame for Assembly_v2.1.FCStd

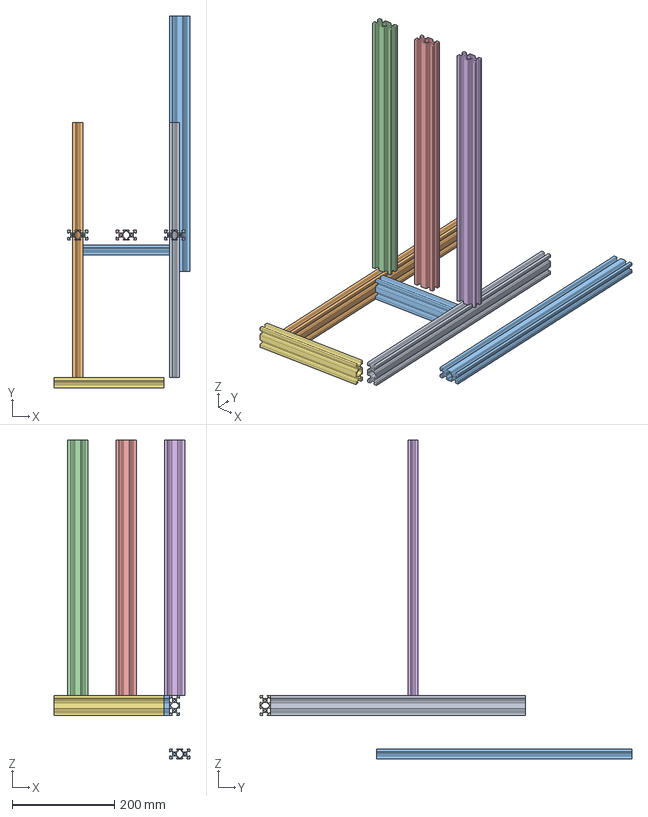
[picture p19: CAD file, 2026-11-09, an earlier design]
Project Files/CAD Files/Frame for Assembly_v2.1.FCStd
266.0 x 728.4 x 624.8 mm
20mmx40mm extruded aluminum
20mmx40mm extruded aluminum007
20mmx40mm extruded aluminum003
20mmx40mm extruded aluminum006
20mmx40mm extruded aluminum004
20mmx40mm extruded aluminum005
20mmx40mm extruded aluminum008
