SahinS14/ShuddhiSetu/(list of files, cad)

Other CAD files:
pressure_vessel.scad
