SahinS14/ShuddhiSetu/Project Files/PCB Design/Control Board.kicad_pcb

## KiCad design Project Files/PCB Design/Control Board.kicad_pcb (2026-11-09)

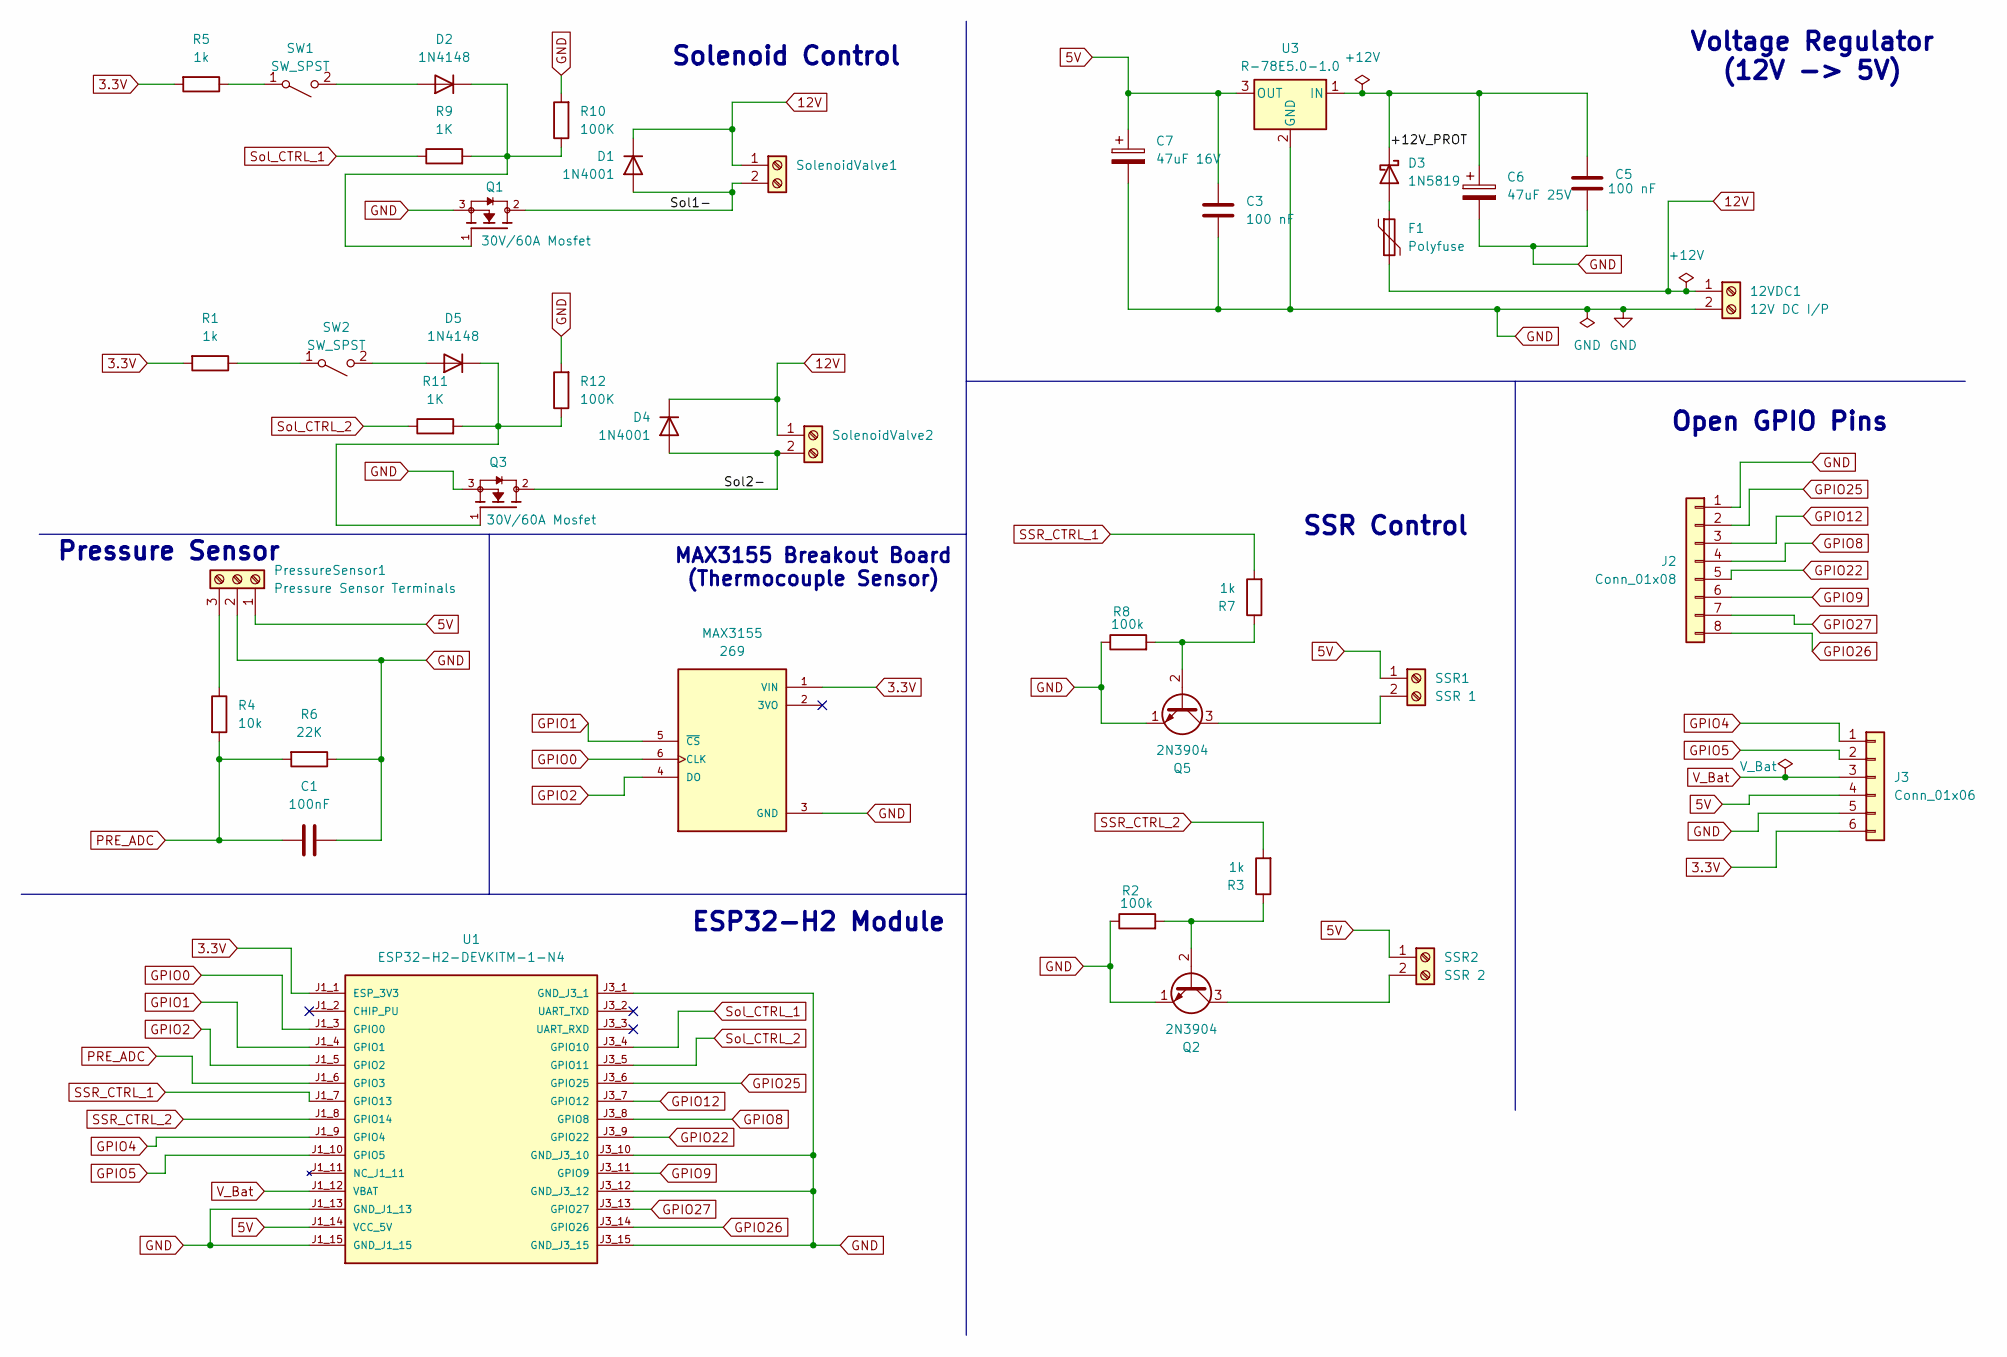
[picture p20: schematic Control Board.kicad_sch, Bio-Char Control Board]

Parts:
12VDC1: 12V DC I/P; TerminalBlock_Phoenix_MKDS-1,5-2-5.08_1x02_P5.08mm_Horizont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
C1: 100nF; C_Disc_D5.0mm_W2.5mm_P5.00mm
C3, C5: 100 nF; C_Disc_D5.0mm_W2.5mm_P5.00mm
C6: 47uF 25V; CP_Radial_D6.3mm_P2.50mm
C7: 47uF 16V; CP_Radial_D6.3mm_P2.50mm
D1, D4: 1N4001; D_DO-41_SOD81_P10.16mm_Horizontal
D2, D5: 1N4148; D_DO-35_SOD27_P7.62mm_Horizontal
D3: 1N5819; D_DO-41_SOD81_P10.16mm_Horizontal
F1: Polyfuse; Fuse_BelFuse_0ZRE0008FF_L8.3mm_W3.8mm
J2: Conn_01x08; PinHeader_1x08_P2.54mm_Vertical
J3: Conn_01x06; PinHeader_1x06_P2.54mm_Vertical
MAX3155: 269; MODULE_269; PARTREV 2.0
PressureSensor1: Pressure Sensor Terminals; TerminalBlock_Phoenix_MKDS-1,5-3-5.08_1x03_P5.08mm_Horizont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
Q1, Q3: 30V/60A Mosfet; TO254P1067X483X2057-3; PARTREV 4/22/09
Q2, Q5: 2N3904; TO-92_Inline
R1, R3, R5, R7: 1k; R_Axial_DIN0207_L6.3mm_D2.5mm_P7.62mm_Horizontal
R2, R8: 100k; R_Axial_DIN0207_L6.3mm_D2.5mm_P7.62mm_Horizontal
R4: 10k; R_Axial_DIN0207_L6.3mm_D2.5mm_P7.62mm_Horizontal
R6: 22K; R_Axial_DIN0207_L6.3mm_D2.5mm_P7.62mm_Horizontal
R9, R11: 1K; R_Axial_DIN0207_L6.3mm_D2.5mm_P7.62mm_Horizontal
R10, R12: 100K; R_Axial_DIN0207_L6.3mm_D2.5mm_P7.62mm_Horizontal
SSR1: SSR 1; TerminalBlock_Phoenix_MKDS-1,5-2-5.08_1x02_P5.08mm_Horizont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
SSR2: SSR 2; TerminalBlock_Phoenix_MKDS-1,5-2-5.08_1x02_P5.08mm_Horizont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
SW1, SW2: SW_SPST; PinHeader_1x02_P2.54mm_Vertical
SolenoidValve1, SolenoidValve2: TerminalBlock_Phoenix_MKDS-1,5-2-5.08_1x02_P5.08mm_Horizont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
U1: ESP32-H2-DEVKITM-1-N4; MODULE_ESP32-H2-DEVKITM-1-N4; PARTREV 1.2
U3: R-78E5.0-1.0; Converter_DCDC_RECOM_R-78E-0.5_THT

Connections:
3.3V: J3.6, MAX3155.1 (VIN), R1.2, R5.2, U1.J1_1 (ESP_3V3)
5V: C3.1, C7.1, J3.4, PressureSensor1.1, SSR1.1, SSR2.1, U1.J1_14 (VCC_5V), U3.3 (OUT)
12V: 12VDC1.1, D1.1 (K), D4.1 (K), F1.2, SolenoidValve1.1, SolenoidValve2.1
/+12V_PROT: C5.1, C6.1, D3.1 (K), U3.1 (IN)
/Sol1-: D1.2 (A), Q1.2, SolenoidValve1.2
/Sol2-: D4.2 (A), Q3.2, SolenoidValve2.2
GND: 12VDC1.2, C1.1, C3.2, C5.2, C6.2, C7.2, J2.1, J3.5, MAX3155.3 (GND), PressureSensor1.2, Q1.3, Q2.1 (E), Q3.3, Q5.1 (E), R2.1, R6.1, R8.1, R10.2, R12.2, U1.J1_13 (GND_J1_13), U1.J1_15 (GND_J1_15), U1.J3_1 (GND_J3_1), U1.J3_10 (GND_J3_10), U1.J3_12 (GND_J3_12), U1.J3_15 (GND_J3_15), U3.2 (GND)
GPIO0: MAX3155.6 (CLK), U1.J1_3 (GPIO0)
GPIO1: MAX3155.5 (~CS), U1.J1_4 (GPIO1)
GPIO2: MAX3155.4 (DO), U1.J1_5 (GPIO2)
GPIO4: J3.1, U1.J1_9 (GPIO4)
GPIO5: J3.2, U1.J1_10 (GPIO5)
GPIO8: J2.4, U1.J3_8 (GPIO8)
GPIO9: J2.6, U1.J3_11 (GPIO9)
GPIO12: J2.3, U1.J3_7 (GPIO12)
GPIO22: J2.5, U1.J3_9 (GPIO22)
GPIO25: J2.2, U1.J3_6 (GPIO25)
GPIO26: J2.8, U1.J3_14 (GPIO26)
GPIO27: J2.7, U1.J3_13 (GPIO27)
unnamed: D2.2 (A), SW1.2 (B)
unnamed: D2.1 (K), Q1.1, R9.2, R10.1
unnamed: D3.2 (A), F1.1
unnamed: D5.2 (A), SW2.2 (B)
unnamed: D5.1 (K), Q3.1, R11.2, R12.1
unnamed: PressureSensor1.3, R4.1
unnamed: Q2.2 (B), R2.2, R3.1
unnamed: Q2.3 (C), SSR2.2
unnamed: Q5.2 (B), R7.1, R8.2
unnamed: Q5.3 (C), SSR1.2
unnamed: R5.1, SW1.1 (A)
unnamed: R1.1, SW2.1 (A)
PRE_ADC: C1.2, R4.2, R6.2, U1.J1_6 (GPIO3)
SSR_CTRL_1: R7.2, U1.J1_7 (GPIO13)
SSR_CTRL_2: R3.2, U1.J1_8 (GPIO14)
Sol_CTRL_1: R9.1, U1.J3_4 (GPIO10)
Sol_CTRL_2: R11.1, U1.J3_5 (GPIO11)
V_Bat: J3.3, U1.J1_12 (VBAT)

Notes on the sheet:
SSR Control
Pressure Sensor
Voltage Regulator (12V -> 5V)
MAX3155 Breakout Board (Thermocouple Sensor)
Solenoid Control
ESP32-H2 Module
Open GPIO Pins

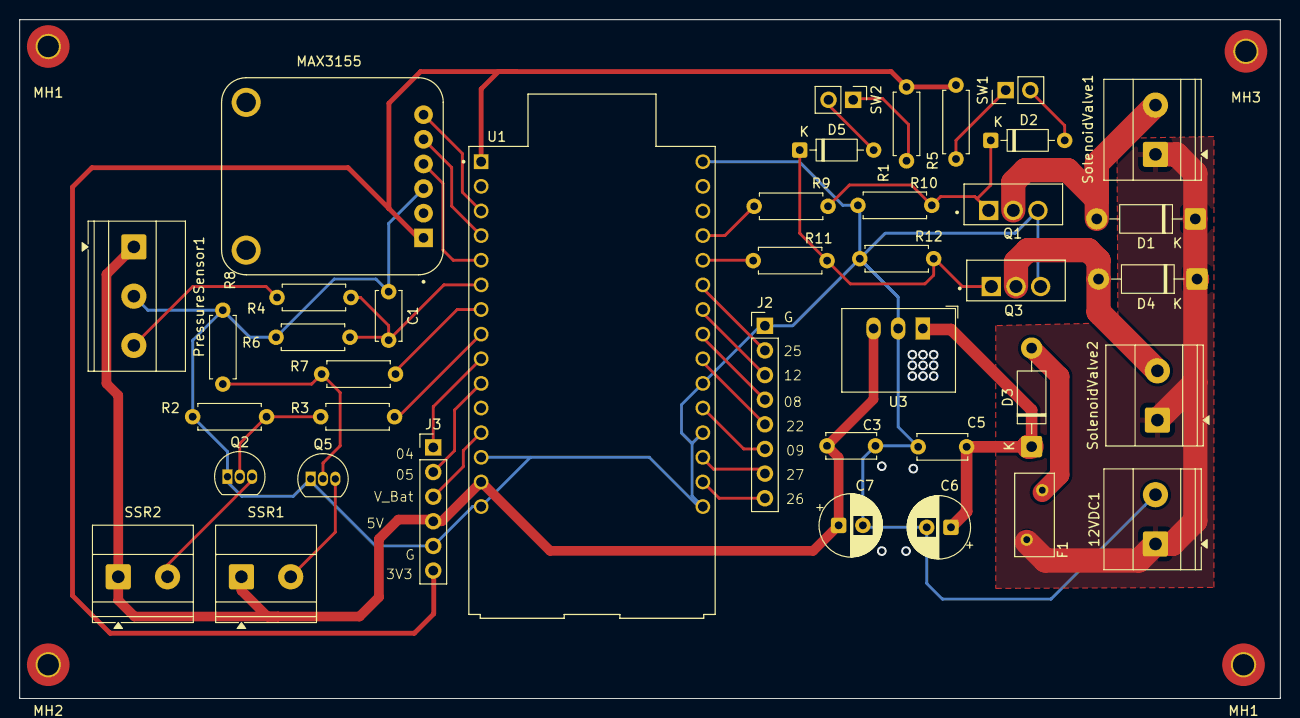
[picture p21: board Control Board.kicad_pcb from above]

Board: 2 copper layers, 130.0 x 70.0 mm, 44 parts (0 on the bottom side), 37 nets.

Other parts of the board:
MH1, MH1#2, MH2, MH3: MountingHole_2.2mm_M2_Pad_TopBottom
